zwilson14/Patch-Antenna-Transmitter---Microwaves/Final Setup.jpg

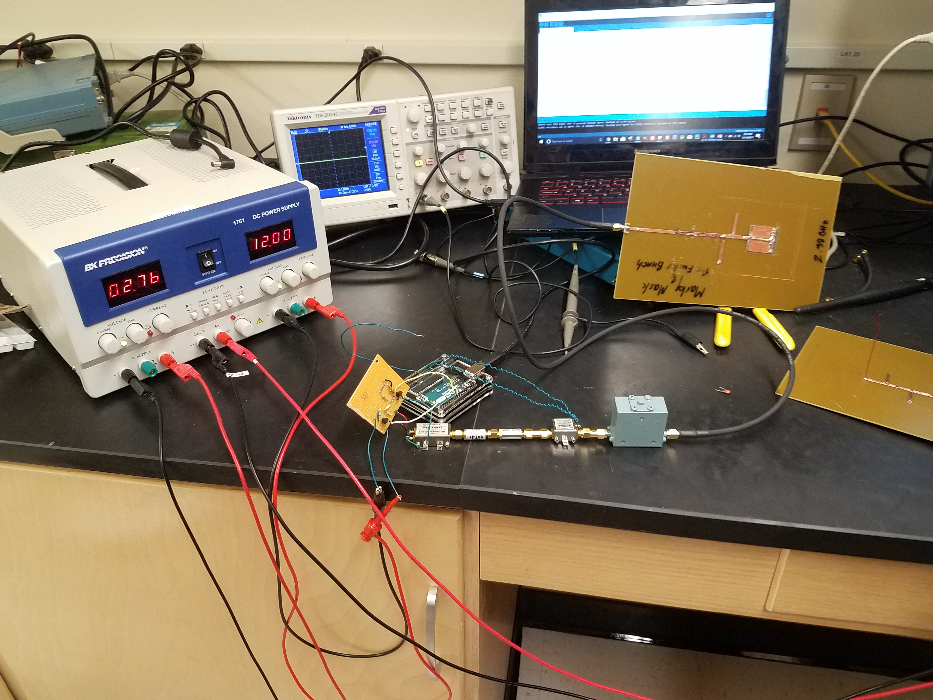
Final Setup.jpg
