zwilson14/Patch-Antenna-Transmitter---Microwaves/README.md

# Patch-Antenna-Transmitter---Microwaves
Final project for ENGE 360 (Microwaves)

The report was done in two parts (This was printed).
See "Summary Lab 9.docx" and "Pic presentation Lab 9.docx"
