zwilson14/Patch-Antenna-Transmitter---Microwaves/12-13 - Patch Antenna Matched, SWR, RL.PNG

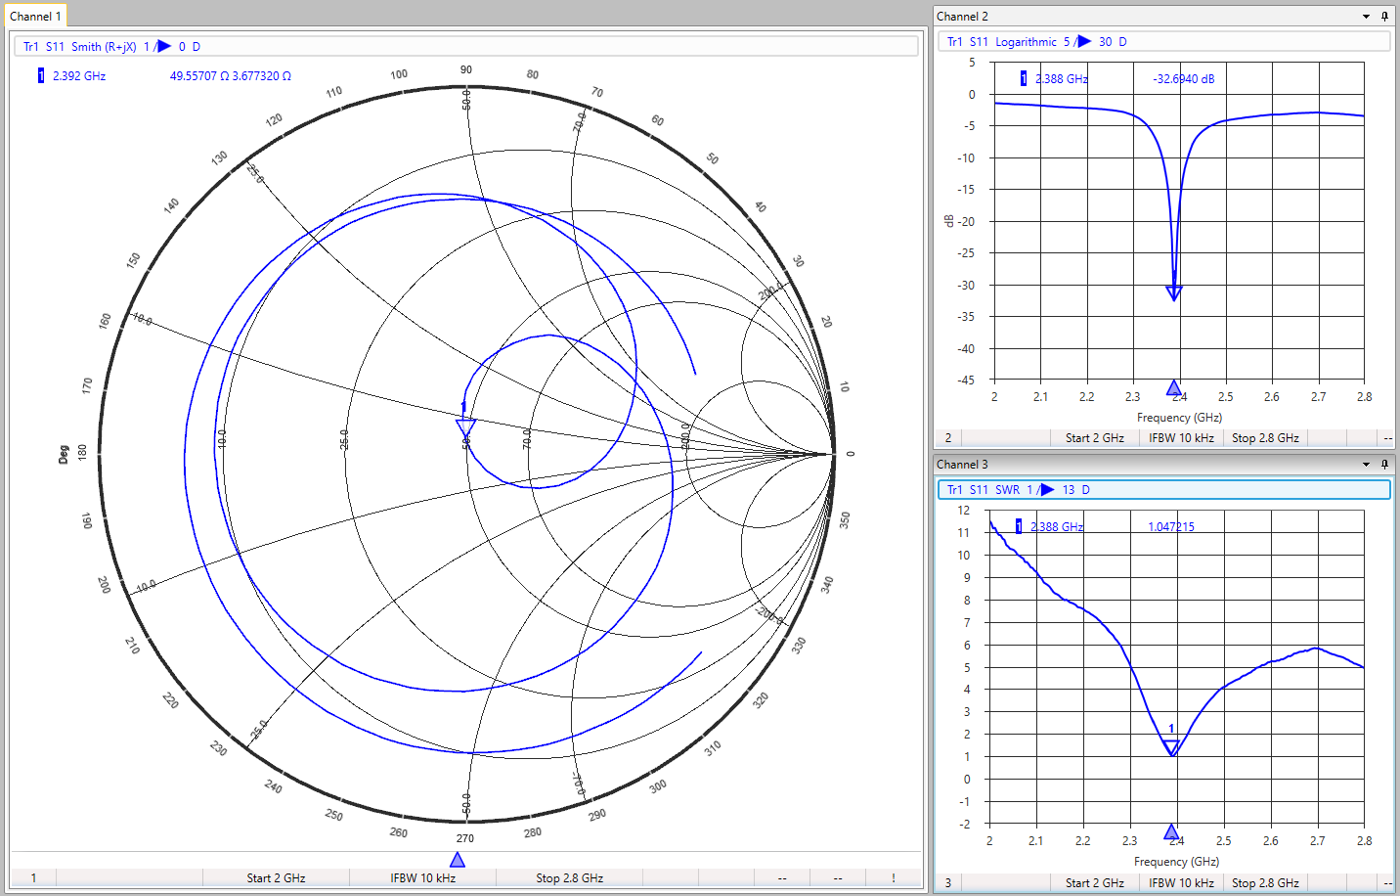
12-13 - Patch Antenna Matched, SWR, RL.PNG
